eSpark-Backup/oliver-arc/Documents/Client-Shared/ARC103C_CURRENT VERSION/Assembly Pictures/T-U18W203868A-03.jpg

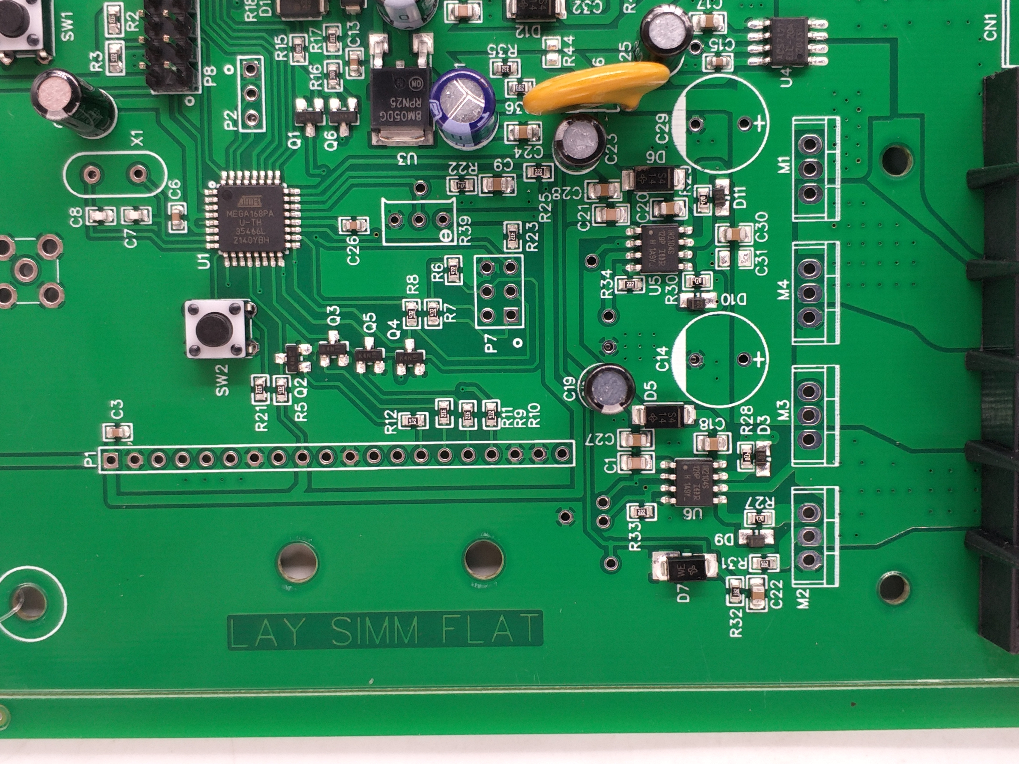
Documents/Client-Shared/ARC103C_CURRENT VERSION/Assembly Pictures/T-U18W203868A-03.jpg
