eSpark-Backup/oliver-arc/Documents/Client-Shared/ARC103C_CURRENT VERSION/BOMs/T-U18W203868A- ARC1.0.3C - 26122021.xlsx

Sheet: BOM Verfied by UK-DavidCousins
Columns C,D,E,F and G are the correct BOM (Parts idents are in Column F).
Column B is the original Quantity, column H is the original ident list do not use these there for reference only
Columns I,J and K are the original order codes for the devices use these for purchasing against the quantity in column D
Where columns I,J and K du not have the original order codes see the notes in column C, especially for the additional parts
 |  |  |  |  | Correct BOM checked December 2021
UK BUILD INFORMATION AND REVIEW - CORRECT BOM CHECK DECEMBER 2021 BY DAVID COUSINS / KAIZEN |  |  |  |  |  |  | CHINESE FACTORY BOM INFO
Column1 | Quantity | PB notes based on sample Board 06.10.2020 | Qty based on sample 06.10.2021 | Type | PB notes based on sample Board 06.10.20202 | PB notes based on sample Board 06.10.20203 | Original BOM data - ignore use Blue | Assembly Mounte Ref | Part description | part number supplied | NOTE | Column2
1 | 1 | ok | 1 | SMT | U1 |  | U1 | ATMEGA168 | ATMEGA168PA-AU | ATMEGA168PA-AU
2 | 2 | ok | 2 | SMT | U5,U6 |  | U5,U6 | IR2104 | IR2104STRPBF | IR2104STRPBF
3 | 1 | ok | 1 | SMT | U4 |  | U4 | ACS712 | ACS712ELCTR-20A-T SOIC-8_150MIL | ACS712ELCTR-20A-T
4 | 1 | ok marking = 8M05D | 1 | SMT | U3 |  | U3 | 78L05 | MC78M05ACDTG | MC78M05ACDTG | 5-7work days
5 | 1 | ok | 1 | SMT | U2 |  | U2 | MC34063 | MC34063 | MC34063AD
6 | 1 | ok | 1 | SMT | R42 |  | R42 | 0.3 0603 | 0.3 Ohm | CRL0603-FW-R300ELF
7 | 1 | ok | 1 | SMT | R40 |  | R40 | 180 0603 | 180 ohm | ERJ3RBD1800V | 5-7work days
8 | 1 | ok | 1 | SMT | R22 |  | R22 | 470K 0603 | 470K 0603
9 | 1 | ok | 1 | SMT | R43 |  | R43 | 1K 0603 | 1K
10 | 4 | ok | 4 | SMT | R27,R28,R29,R30 |  | R27,R28,R29,R30 | 47 | 47 Ohm Gate resistors |  |  |  | 603
11 | 1 | ok | 1 | SMT | R45 |  | R45 | 0 | Resistor 0 Ohm 0603 | CRCW06030000Z0EB |  |  | 603
12 | 6 | R4,R14 = 470, R13,R19,R20,R37 no silk on sample 06/10/20 or Schematic | 2 | SMT | R4,R14 | change | R4,R13, R14, R19, R20,R37 | 470 0603 | Resistor 470 0603
13 | 14 | R1,R2,R3,R38 = 4K7, R48 and R49 not fitted on sample 06/10/20 | 14 | SMT | R1,R2,R3,R5,R6,R7,R8,R9,R10,R11,R12,R21,R23,R38 |  | R1,R2,R3,R5,R6,R7,R8,R9,R10,R11,R12,R21,R23,R38 | 4K7 0603 | Resistor 4K7 0603
14 | 5 | ok | 3 | SMT | R25,R33,R34 | change | R15,R16,R25,R33,R34 | 2K2 0603 | Resistor 2K2 0603
15 | 3 | ok | 5 | SMT | R15,R16,R17,R18,R41 | change | R17,R18,R41 | 10K 0606 | Resistor 10k 0603
16 | 1 | ok | 1 | SMT | R24 |  | R24 | 33 1205 | Resistor 33 1206 | CRG1206F33R
17 | 1 | ok | 1 | SMT | R31 |  | R31 | 5K6 0603 | Resistor 5K6 0603 Motor spool
18 | 2 | ok | 2 | SMT | R32,R35 |  | R32,R35 | 3K3 0603 | Resistor 3K3 0603 |  |  |  |  |  | Motor spool + Batt Mon
19 | 1 | ok | 1 | SMT | R36 |  | R36 | 6K8 0603 | Resistor 6K8 0603 Batt Mon
20 | 1 | ok | 1 | CONV | R39 |  | R39 | POT 2K2 | Pot 2K2 3296w | 3296W-1-222LF | DNP
21 | 1 | ok | 1 | CONV | R46 |  | R26 | Varistor | VARISTOR 10A Clamp 43V Varistor 22V | 820541406 | 5-7work days
22 | 0 |  |  |  |  |  |  |  | Resistor 22 |  | DNP | NOT USED - redundant part
23 | 3 | D1 and D2 are SMAJ18CA-T on Sample board (marked ST part DBQ), D7 = SMAJ5.0CA (Not ST part on sample) | 1 | SMT | D7 | change | D1,D2,D7 | SMAJ5.0 | SMAJ5.0CA (DO-214AC) | SMAJ5.0CA
24 | 1 | ok D4 marked MMD | 1 | SMT | D4 |  | D4 | SS510 | SS510 5A Diode SMB(DO-214AA) | SS510 | Brand is MDD
25 | 7 | Marking K4N on these devices, Q8,Q9,Q10 not fitted on sample 06/10/20 | 7 | SMT | Q1,Q2,Q3,Q4,Q5,Q6,Q7 |  | Q2,Q3,Q4,Q5,Q1,Q6,Q7 | MMBT5551 | MMBT5551 SOT-23(SOT-23-3) | MMBT5551-7-F
26 | 4 | IRF3205 Fitted to sample 06/10/20 (will need fastenings) | 4 | CONV | M1,M3,M4,M2 |  | M1,M3,M4,M2 | IRF3205 | IRF3205PBF 110A 55V MOSFET TO-220 | IRF3205PBF | DNP
27 | 1 |  |  |  |  | change | D8 | Zenar 16V | Zenar 16V 6% 3 W SMT 2-Pin DO-214AC | BZG03C16TR | DNP
28 | 2 | Only LED3 fitted, | 1 | SMT | LED3 | change | LED3,LED4 | LED red | LED Red | LH R974-LP-1 | 5-7work days
29 | 1 | Not on silk or schematic |  |  | N/A | change | LED1 | LED green | LED Green | KP-2012CGCK | 5-7work days
30 | 1 | Not on silk or schematic |  |  | N/A | change | LED2 | LED yellow | LED Yellow | KPHCM-2012SYCK | 5-7work days
31 | 3 | ok all marked S4 = SS14 device | 3 | SMT | D5,D6,D12 |  | D5,D6,D12 | SS14 | SS14-E3/61T SMA(DO-214AC) | SS14-E3/61T
32 | 4 | ok all marked JP = 1N4148 device | 4 | SMT | D3,D9,D10,D11 |  | D3,D9,D10,D11 | 1N4148 | 1n4148 SMD | 1N4148WSF-7 | 5-7work days
33 | 1 | ok | 1 | SMT | L1 |  | L1 | 100uH | 100uH Inductor | SRN8040-101M | 5-7work days
34 | 1 | ok | 1 | CONV | C12 |  | C12 | 220uf | Capacitor 220uf | UVR1A221MED | 5-7work days |  |  |  | CAP-D6.3XF2.5 10v
35 | 3 | ok | 3 | CONV | C16,C14,C29 |  | C16,C14,C29 | 470uf | Capacitor 470u 10mm OD 50V | ECA1HM471 | 5-7work days
36 | 1 | ok | 1 | CONV | C11 |  | C11 | 100uf | Capacitor 100uf | ECA1VM101 | 5-7work days |  |  |  | CAP-D6.3XF2.5 35v
37 | 2 | ok | 2 | SMT | C34,C35 |  | C34,C35 | 10Uf Tant | 10uf 35v Tant capacitor | TAJC106K035RNJ | 3-4work days
38 | 4 | ok | 4 | CONV | C2,C19,C23,C25 |  | C2,C19,C23,C25 | 10Uf | 10u | ECA1HM100 | 5-7work days |  | 5x2 50v PC
39 | 11 | 1u listed in Schematics | 11 | SMT | C4,C5,C9,C17,C18,C20,C22,C24,C27,C28,C30 |  | C4,C5,C9,C17,C18,C20,C22,C24,C27,C28,C30 | 1uf 0805 | Capacitor 1u 0805 | CL21B105KBFNNNF
40 | 3 | 100n listed in Schematics | 3 | SMT | C1,C21,C10 |  | C1,C21,C10 | 100n 50v 0805 | 100n 0805 50v | C0805C104M5RACTU |  |  |  |  | C1,21,C10
41 | 2 | 18p listed in Schematics | 2 | SMT | C7,C8 |  | C7,C8 | 18P 0603 | Capacitor 18P 0603 | 06031A180JAT2A | 5-7work days
42 | 8 | 100n listed in Schematics | 8 | SMT | C3,C6,C13,C15,C26,C37,C36,C33 |  | C3,C6,C13,C15,C26,C37,C36,C33 | 100n 0603 | 100n 0603 | GRM188F51E104ZA01D |  |  |  | 25v
43 | 1 | 1n listed in Schematics | 1 | SMT | C32 |  | C32 | 1n 0603 | 1nf | 06031C102KAT2A
44 | 0 |  |  |  |  |  |  |  | 470P? |  | DNP | NOT USED - redundant part
45 | 1 | Not purchased (RS 704-3278) added to purchase list | 1 | CONV | P1 |  |  | RDF1 | RDF1 | RDF1 | DNP | PLEASE SOURCE FROM https://www.rfsolutions.co.uk/
46 | 1 | Purchased | 1 | CONV | J1 |  |  | Antenna | Antenna with Pig Tail - 433MHz 2db gain | ANT-433WPIG-2SMA | DNP
47 | 1 |  |  |  |  | change |  | Key fob | Key fob |  | DNP | PLEASE SOURCE FROM https://www.rfsolutions.co.uk/
48 | 1 | Purchased | 1 | CONV | SG1 |  |  | Buzzer | BUZZER 12mm 5V | KXG1203C | Out of stock, please kindly advise alternatives.
49 | 1 | Purchased SMT Device (Bend pins and fit through the PCB) | 1 | CONV | X1 |  | X1 | 12MHz288 | 12.288 MHZ HC49 | ABLS-12.288MHZ-B2-T | 5-7work days
50 |  | Not purchased (Fitted on sample 06/10/20) (RS 251-8288) | 1 | CONV | P8 | change |  |  | LCD Header 16 pin |  | DNP | LCD version only
51 |  |  |  |  |  |  |  |  | lCD IDC PLUG 16 pin |  | DNP | LCD version only
52 |  |  |  |  |  |  |  |  | Box |  | DNP | GrippaTank – see Olly – requires drilling
53 | 2 | ok | 2 | CONV | SW1,SW2 |  | SW1,SW2 | Switch | SWITCH-6x6x5_TH | 1825910-6 | 7-10work days
54 |  |  |  |  |  |  |  |  | PCB |  | PCB | GrippaTank specically made – see Olly
55 | 1 | Purchased (Fitted on sample 06/10/20) (RS 822-7070) | 1 | CONV | No Ident on silk Screen (next to CN1) |  |  |  | Barrer strip 4 contact Molex 9.53mm Pitch 15A | 38720-6204 | 5-7work days
56 | 1 | Purchased (Fitted on sample 06/10/20) (RS 897-0749) | 1 | CONV | CN1 |  | CN1 |  | Terminal screw block for hand remote | 897-0749 | DNP
57 | 6 | Purchased SMT part (Fitted on sample 06/10/20) (Buy RS 251-8137) | 1 | CONV | P7 | change | P7 | 3x2 | Header pins 0.1 inch |  | DNP | Standard 0.1” header pins
58 | 4 | Purchased - Fitted to Sample 06/10/20 | 4 | Mech | (M1,M3,M4,M2) assembly Insulator/Busj |  |  |  | Heatsink MOSFET insulator and bush |  | DNP | Farnell – packet of 10!!
59 | 4 | Purchased - Fitted to Sample 06/10/20 | 4 | Mech | (M1,M3,M4,M2) assembly washer |  |  |  | Heatsink MOSFET Steel washer M3 |  | DNP | Washer for nut side of MOSFET bolt
 | 4 | Purchased - Fitted to Sample 06/10/20 | 4 | Mech | (M1,M3,M4,M2) assembly Screw |  |  |  | Heatsink MOSFET machine screw M3 X 12 |  | DNP | Bolt for MOSFET to heatsink
 | 2 | Purchased - Fitted to Sample 06/10/20 | 2 | Mech | (M1,M3,M4,M2) assembly Screw |  |  |  | Heatsink machine screw M3 X 9 |  | DNP | Heatsink to PCB bolt
60 | 2 | Purchased - Fitted to Sample 06/10/20 | 2 | Mech | (M1,M3,M4,M2) assembly washer |  |  |  | Heatsink M3 steel washer |  | DNP | Heatsink to PCB underside washer
61 | 1 | Purchased - Fitted to Sample 06/10/20 | 2 | Mech | (M1,M3,M4,M2) assembly washer | change | Nylon washer / steel washer /nut |  | Heatsink M3 Nylon washer |  | DNP | Heatsink to PCB underside nylon washer ( By MOSFET M1 )
62 |  |  |  |  |  |  |  |  |  |  | DNP
63 | 2 |  |  |  |  | change |  |  | Machine screw M3 x 16 |  | DNP | Terminaltion block securing screw
64 | 2 |  |  |  |  | change |  |  | M3 Steel washer |  | DNP | Terminaltion block securing screw underside Steel washer
65 | 1 |  |  |  |  | change | Nylon washer / steel washer /nut |  | M3 Nylon washer |  | DNP | Terminaltionterminal ) block securing screw underside Nylon washer ( by 12V+
 | 8 | Purchased - Fitted to Sample 06/10/20 | 4 | Mech | (M1,M3,M4,M2) assembly Nut | change |  |  | M3 Nyloc nut |  | DNP | Nyloc nuts for all M3 machine screws
66 | 1 |  |  |  |  | change |  |  | Cable clamp 16MM thread – Black | NGM16-BLK | DNP
67 | 1 |  |  |  |  | change |  |  | Cable clamp 12MM thread – Black | NGM12-BLK | DNP | Needs slightly longer threaded version!!
68 | 4 |  |  |  |  | change |  |  | PCB mounting screws 6-32 x ¼ UNC cap screw |  | DNP | GrippTank sourced – see Olly
69 | 1 |  |  |  |  | change |  |  | Right angle 70mm heat-sink |  | DNP | GrippaTank specically made – see Olly
70 | 1 | Not Purchased (Added FEC 8783551 to prurchase list) |  |  |  | change |  |  | Heatsink bottom insulator |  | DNP | Custom made to suit heat-sink area
 | PB added | Molex connector fitted on sample 06/10/20 (RS 170-7177) | 1 | CONV | JP2 | change |  | Fitted on sample
 | PB added | SMAJ18CA (DO-214AC (Farnell 1749352) | 2 | SMT | D1,D2 | change |  | Fitted on sample
 | PB added | 0.1" pitch 1 x 3 header (RS 251-8092) | 1 | CONV | P2 | change |  | Fitted on sample
 | PB added | Confirmed with sample 06/10/20 and Schematic | 7 | NF | Q8,Q9,Q10,R44,R48,R49,C31 | change |  | NOT FITTED

Sheet: BOM Sent to China Factory
Last Revision: 26/12/2021 - Validated and Compared with Build Unit as emailed by D.C/KT - 13/12/21
100sets |  | CUSTOMER REPLY | part number supplied |  | Part description | MOQ | Quantity | Package | Supplier | Supplier Code | Alternative | Assembly Mounted | Ref
$6.710 |  | - | ATMEGA168PA-AU | 43 | ATMEGA168PA-AU |  | 1 | TQFP32 | RS | 696-3244 |  | ATMEGA168 | U1
$1.760 |  | - | IR2104STRPBF | 70 | IR2104STRPBF |  | 2 |  | RS | 831-2724 |  | IR2104 | U5,U6
$3.080 |  | - | ACS712ELCTR-20A-T | 51 | ACS712ELCTR-20A-T SOIC-8_150MIL |  | 1 |  | RS | 680-7135 |  | ACS712 | U4
$0.660 | 7-10work days | No Problem | MC78M05ACDTG | 46 | MC78M05ACDTG |  | 1 |  | RS | 688-9288 |  | 78L05 | U3
$0.550 |  | - | MC34063AD | 1 | MC34063 |  | 1 |  | RS | 661-8436 |  | MC34063 | U2
$0.242 | 7-10work days | No Problem | CRL0603-FW-R300ELF | 1 | 0.3 Ohm |  | 1 |  | RS | 794-4112 |  | 0.3 0603 | R42
$0.088 | 7-10work days | No Problem | ERJ3RBD1800V | 80 | 180 ohm |  | 1 |  | RS | 810-2157 |  | 180 0603 | R40
$0.008 |  | - |  | 4000 | 470K 0603 | Reel of 5000 = 3.77 | 1 |  | RS | 804-9069 |  | 470K 0603 | R22
$0.008 |  | - |  | 4000 | 1K | Reel 0f 5000 = 3.61 | 1 |  | RS | 804-8845 |  | 1K 0603 | R43
$0.008 |  | - |  | 4000 | 47 Ohm Gate resistors | Reel 0f 5000 = 3.57 | 4 |  | RS | 804-8748 |  | 47 0603 | R27,R28,R29,R30
$0.008 |  | - | CRCW06030000Z0EB | 80 | Resistor 0 Ohm 0603 | Packet of 50 = 0.40 | 1 |  | RS | 678-9670 |  | 0 0603 | R45
$0.008 |  | - |  | 4000 | Resistor 470 0603 | Reel 0f 5000 = 3.77 | 6 | R0603 | RS | 804-8827 |  | 470 0603 | R4,R13, R14, R19, R20,R37
$0.008 |  | - |  | 4000 | Resistor 4K7 0603 | Reel of 5000 = 3.77 | 14 | R0603 | RS | 804-8909 |  | 4K7 0603 | R1,R2,R3,R5,R6,R7,R8,R9,R10,R11,R12,R21,R23,R38,R47,R48,R49
$0.008 |  | - |  | 4000 | Resistor 2K2 0603 | Reel of 5000 = 3.77 | 5 |  | RS | 804-8861 |  | 2K2 0603 | R25,R33,R34
$0.008 |  | - |  | 4000 | Resistor 10k 0603 | Reel of 5000 = 3.56 | 3 |  | RS | 804-8921 |  | 10K 0606 | R15,R16,R17,R18,R41
$0.017 |  | - | CRG1206F33R | 30 | Resistor 33 1206 | Packet of 50 = 1.35 | 1 |  | RS | 223-2063 |  | 33 1205 | R24
$0.008 |  | - |  | 4000 | Resistor 5K6 0603 Motor spool | Reel 0f 5000 = 3.77 | 1 |  | RS | 804-8899 |  | 5K6 0603 | R31
$0.008 |  | - |  | 4000 | Resistor 3K3 0603 Motor spool + Batt Mon | Reel 0f 5000 = 3.77 | 2 |  | RS | 804-8877 |  | 3K3 0603 | R32,R35
$0.008 |  | - |  | 4000 | Resistor 6K8 0603 Batt Mon | Reel 0f 5000 = 3.77 | 1 |  | RS | 804-8915 |  | 6K8 0603 | R36
 | NO NEED? | Yes we do need, but if can't supply, we will add them ourselves here | 3296W-1-222LF | 34 | Pot 2K2 3296w | Tube of 50 = 31.45 | 1 |  | RS | 161-6985 |  | POT 2K2 | R39
$1.100 | 7-10work days | No Problem | 820541406 | 50 | VARISTOR 10A Clamp 43V Varistor 22V |  | 1 |  | RS | 669-4358 |  | Varistor | R46
 | NO NEED? | NO NEED |  | 4000 | Resistor 22
$0.220 |  | - | SMAJ18CA-TR |  | SMAJ18CA-T (DO214AC) |  | 2 |  | RS | 714-1026 |  | SMAJ18CA-T | D1,D2
$0.220 |  | - | SMAJ5.0CA |  | SMAJ5.0CA (DO-214AC) |  | 1 |  | RS | 764-5568 |  | SMAJ5.0 | D7
$0.220 | brand is MDD | - | SS510 | 34 | SS510 5A Diode SMB(DO-214AA) | Packet of 50 = 5.70 | 1 |  | RS | 917-9174 |  | SS510 | D4
$0.132 |  | - | MMBT5551-7-F | 0 | MMBT5551 SOT-23(SOT-23-3) | Packet of 100 = 4.00 | 7 | SOT-23 | RS | 751-4515 |  | MMBT5551 | Q2,Q3,Q4,Q5,Q1,Q6,Q7
 | NO NEED? | Yes we do need, but if can't supply, we will add them ourselves here | IRF3205PBF | 270 | IRF3205PBF 110A 55V MOSFET TO-220 | Tube of 50 = 34.50 | 4 |  | RS | 919-4763 |  | IRF3205 | M1,M3,M4,M2
 | NO NEED? | Yes we do need, but if can't supply, we will add them ourselves here | BZG03C16TR | 12 | Zenar 16V 6% 3 W SMT 2-Pin DO-214AC |  | 1 |  | RS | 814-2783 |  | Zenar 16V | D8
$0.055 | Out of stock, we will supply LTST-C170KRKT 0805 red | NO PROBLEM | LH R974-LP-1 | 25 | LED Red | Packet of 50 = 3.65 | 2 | L0805 | RS | 654-5818 |  | LED red | LED3,LED4
$0.649 | 7-10work days | No Problem | KP-2012CGCK | 30 | LED Green | Packet of 50 = 2.70 | 1 | L0805 | RS | 861-0037 |  | LED green | LED1
$0.649 | MOQ:5pcs7-10work days | No Problem | KPHCM-2012SYCK | 25 | LED Yellow | Packet of 50 = 5.25 | 1 | L0805 | RS | 861-0113 |  | LED yellow | LED2
$0.110 |  | - | SS14-E3/61T | 45 | SS14-E3/61T SMA(DO-214AC) | Packet of 100 = 6.80 | 3 |  | RS | 652-7551 |  | SS14 | D5,D6,D12
$0.110 |  | - | 1N4148WSF-7 | 80 | 1n4148 SMD | Pack of 100 | 4 |  | RS | 133-5600 |  | 1N4148 | D3,D9,D10,D11
 | Please advise part number. | SRN8040-101M |  | 6 | 100uH Inductor |  | 1 |  | RS |  |  | SRN8040-101M | L1
 | Please advise part number. | UVR1A221MED |  | 250 | Capacitor 220uf CAP-D6.3XF2.5 10v |  | 1 |  | RS |  |  | 220uf | C12
 | Out of stock, please kindly advise alternatives. |  | ECA1HM471 | 8 | Capacitor 470u 10mm OD 50V |  | 3 |  | RS | 228-6925 |  | 470uf | C16,C14,C29
$0.220 |  | - | ECA1VM101 | 7 | Capacitor 100uf CAP-D6.3XF2.5 35v | Packet of 200 = 8.80 | 1 |  | RS | 228-6767 |  | 100uf | C11
$0.550 |  | - | TAJC106K035RNJ | 7 | 10uf 35v Tant capacitor |  | 2 |  | RS | 464-7861 |  | 10Uf Tant | C34,C35
$0.132 | 7-10work days | No Problem | ECA1HM100 | 100 | 10u 5x2 50v PC | Packet of 200 = 6.40 | 4 |  | RS | 107-8079 |  | 10Uf | C2,C19,C23,C25
$0.017 |  | - | CL21B105KBFNNNF | 700 | Capacitor 1u 0805 | Packet of 100 = 3.60 | 11 |  | RS | 766-1062 |  | 1uf 0805 | C4,C5,C9,C17,C18,C20,C22,C24,C27,C28,C30
$0.017 |  | - | C0805C104M5RACTU | 400 | 100n 0805 50v C1,21,C10 | Reel of 500 = 7.00 | 3 |  | RS | 802-9920 |  | 100n 50v 0805 | C1,21,C10
$0.099 | 7-10work days | No Problem | 06031A180JAT2A | 200 | Capacitor 18P 0603 | Reel of 250 = 250 | 2 |  | RS | 135-6553 |  | 18P 0603 | C7,C8
$0.017 |  | - | GRM188F51E104ZA01D | 100 | 100n 0603 25v | Packet of 200 = 1.80 | 8 | C0603 | RS | 723-5521 |  | 100n 0603 25v | C3,C6,C13,C15,C26,C37,C36,C33
$0.009 |  | - | 06031C102KAT2A | 450 | 1nf |  | 1 |  |  | 135-6559 |  | 1n 0603 | C32
 | Please advise part number. | NOT USED - REDUNDANT PART |  |  | 470P?
 | NO NEED? | https://www.rfsolutions.co.uk/radio-modules-c10/rdf1-fm-receiver-decoder-module-sil-5-volt-433mhz-p288 | RDF1 | 5 | RDF1 |  | 1 | SIM | RS for now | 704-3278 |  | RDF1
 | NO NEED? | https://www.rfsolutions.co.uk/antennas-c8/2dbi-compact-433mhz-whip-antenna-p122 | ANT-433WPIG-2SMA | 50 | Antenna with Pig Tail - 433MHz 2db gain |  | 1 |  | RS | 793-4351 |  | Antenna
 | Please advise part number. | https://www.rfsolutions.co.uk/remote-control-systems-c9/hornet200-3-button-150m-433mhz-keyfob-transmitter-p764 |  |  | Key fob |  |  |  |  |  |  | Key fob
$2.310 | MOQ:5pcs 7-10work days | No Problem | KXG1203C | 50 | BUZZER 12mm 5V |  | 1 |  | RS | 771-6957 | 767-5367 | Buzzer | SG1
$0.396 | 7-10work days | No Problem | ABLS-12.288MHZ-B2-T | 60 | 12.288 MHZ HC49 | Tube of 25 = 4.25 | 1 |  | RS | 171-0516 |  | 12MHz288 | X1
 | Please advise part number. | 251-8288 |  |  | LCD Header 16 pin |  |  |  | RS | 251-8288 |  |  | P8
 | Please advise part number. | NO NEED |  |  | lCD IDC PLUG 16 pin
 | Please advise part number. | NO NEED |  |  | Box
$0.148 | 6-8work days only have 260pcs in stock | No Problem | 1825910-6 | 80 | SWITCH-6x6x5_TH | Packet of 20 = 1.40 | 2 | 6x6 | RS | 479-1413 |  | Switch | SW1,SW2
 | PCB | - |  |  | PCB
$3.223 | 7-10work days | No Problem | 38720-6204 | 0 | Barrer strip 4 contact Molex 9.53mm Pitch 15A |  | 1 |  | RS | 822-7070
 | NO NEED? | NO NEED |  | 0 | Terminal screw block for hand remote |  | 1 |  | RS | 897-0749
 | NO NEED? | NO NEED |  | 0 | Header pins 0.1 inch |  |  |  | RS | 251-8092 |  |  | P2
 | NO NEED? | NO NEED |  |  | Heatsink insulator |  | 4
 | NO NEED? | NO NEED |  |  | Heatsink washer |  | 4
 | NO NEED? | NO NEED |  |  | Heatsink M3 X 12 |  | 4
 | NO NEED? | NO NEED |  |  | Heatsink M3 Nylock |  | 8
 | NO NEED? | NO NEED |  |  | Heatsink M3 X 12 chassis bolt |  | 2
 | NO NEED? | NO NEED |  |  | M3 washer |  | 8
 | NO NEED? | NO NEED |  |  | M3 Nylon washer |  | 1
 | NO NEED? | NO NEED |  |  | M3 x 16mm Terminal block bolts |  | 2
 | NO NEED? | NO NEED |  | 6 | Cable clamp 16MM thread – Black |  | 1
 | NO NEED? | NO NEED |  | 6 | Cable clamp 12MM thread – Black |  | 1
 | NO NEED? | NO NEED |  |  | 6BA PCB mounting screws |  | 4
 | NO NEED? | NO NEED |  |  | Right angle 70mm heat-sink |  | 1
 | NO NEED? | NO NEED |  |  | Heatsink bottom insulator |  | 1
