eSpark-Backup/oliver-arc/Documents/Client-Shared/ARC103C_CURRENT VERSION/Assembly Pictures/G214MF-AEK-R2 ( by Gainta )(2).PDF

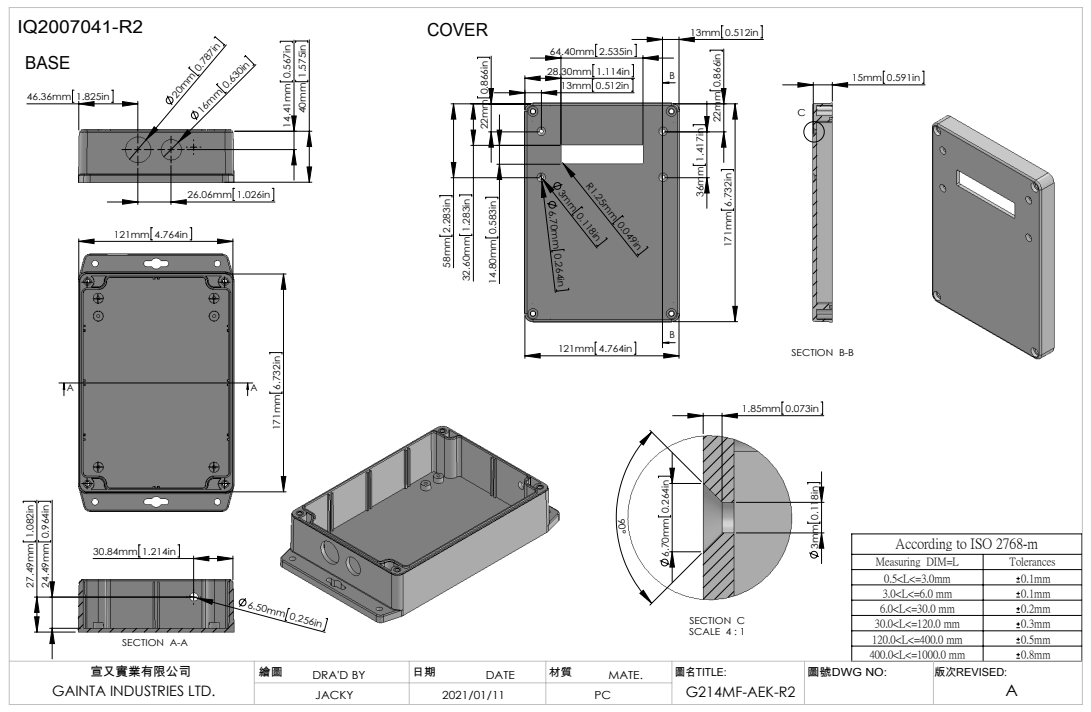
[picture p6: page 1]
SECTION A-A; SECTION B-B; SECTION C SCALE 4 : 1

According to ISO 2768-m

Measuring DIM=L | Tolerances
0.5<L<=3.0mm | 0.1mm
3.0<L<=6.0 mm | 0.1mm
6.0<L<=30.0 mm | 0.2mm
30.0<L<=120.0 mm | 0.3mm
120.0<L<=400.0 mm | 0.5mm
400.0<L<=1000.0 mm | 0.8mm

宣又實業有限公司 GAINTA INDUSTRIES LTD. | 繪圖 DRA'D BY | 日期 DATE | 材質 MATE. | 圖名TITLE: G214MF-AEK-R2 | 圖號DWG NO: | 版次REVISED: A

JACKY | 2021/01/11 | PC
