eSpark-Backup/oliver-arc/Documents/Client-Shared/ARC103C_CURRENT VERSION/VS-1-S.v13.pdf

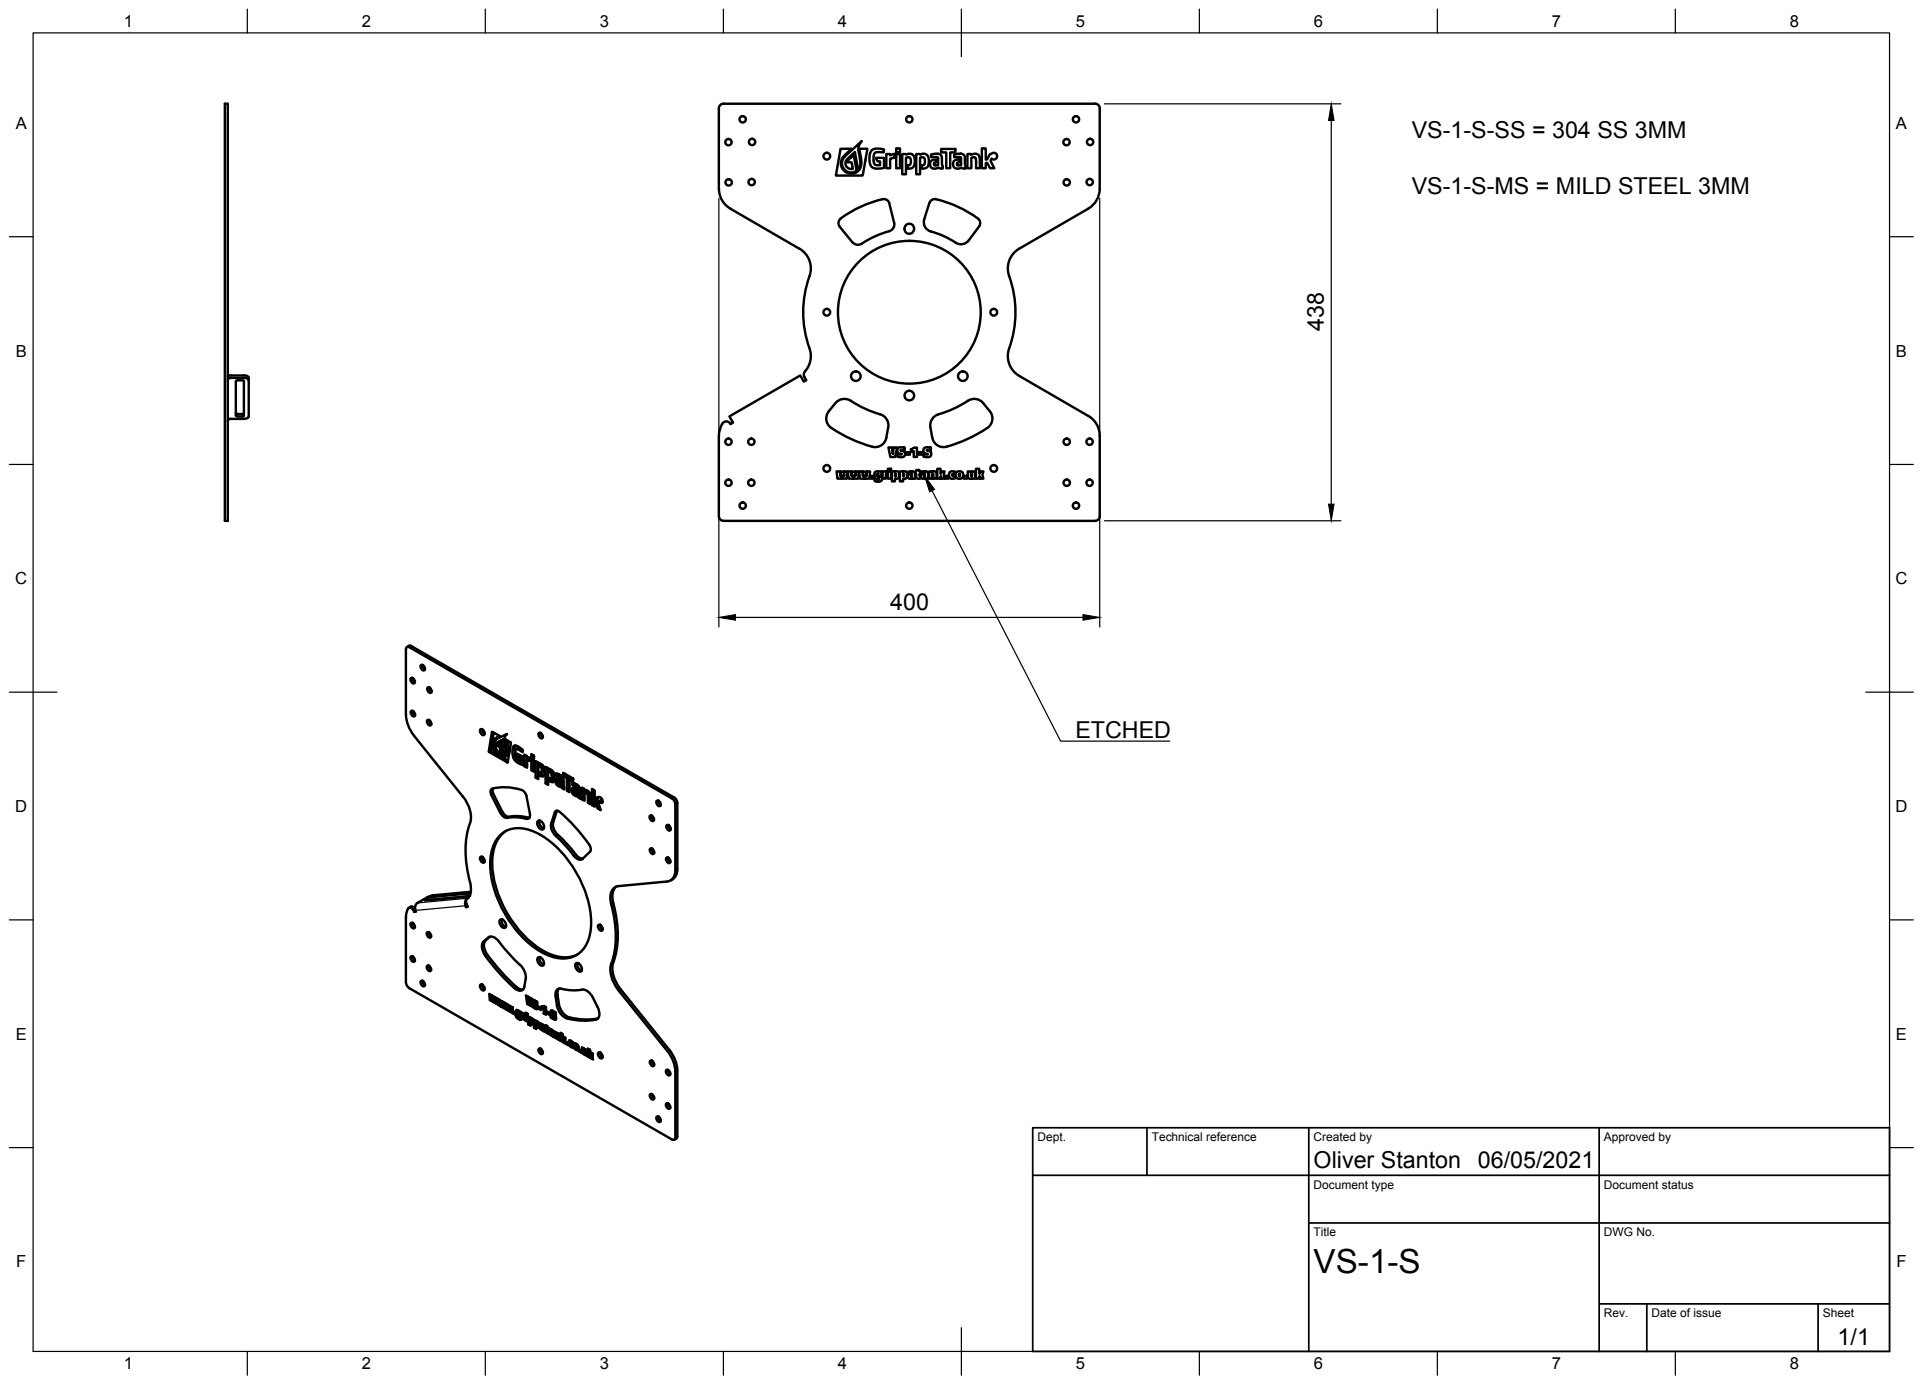
[picture p7: page 1]
Title; DWG No.; Rev.; Date of issue; Sheet

Oliver Stanton 438

VS-1-S-MS = MILD STEEL 3MM

Dept. | Technical reference | Created by 06/05/2021 | Approved by

Document type | Document status
