eSpark-Backup/oliver-arc/Documents/Client-Shared/ARC103C_LCD/Schematics/ARC103C_LCD_LAYOUT_SCH.pdf

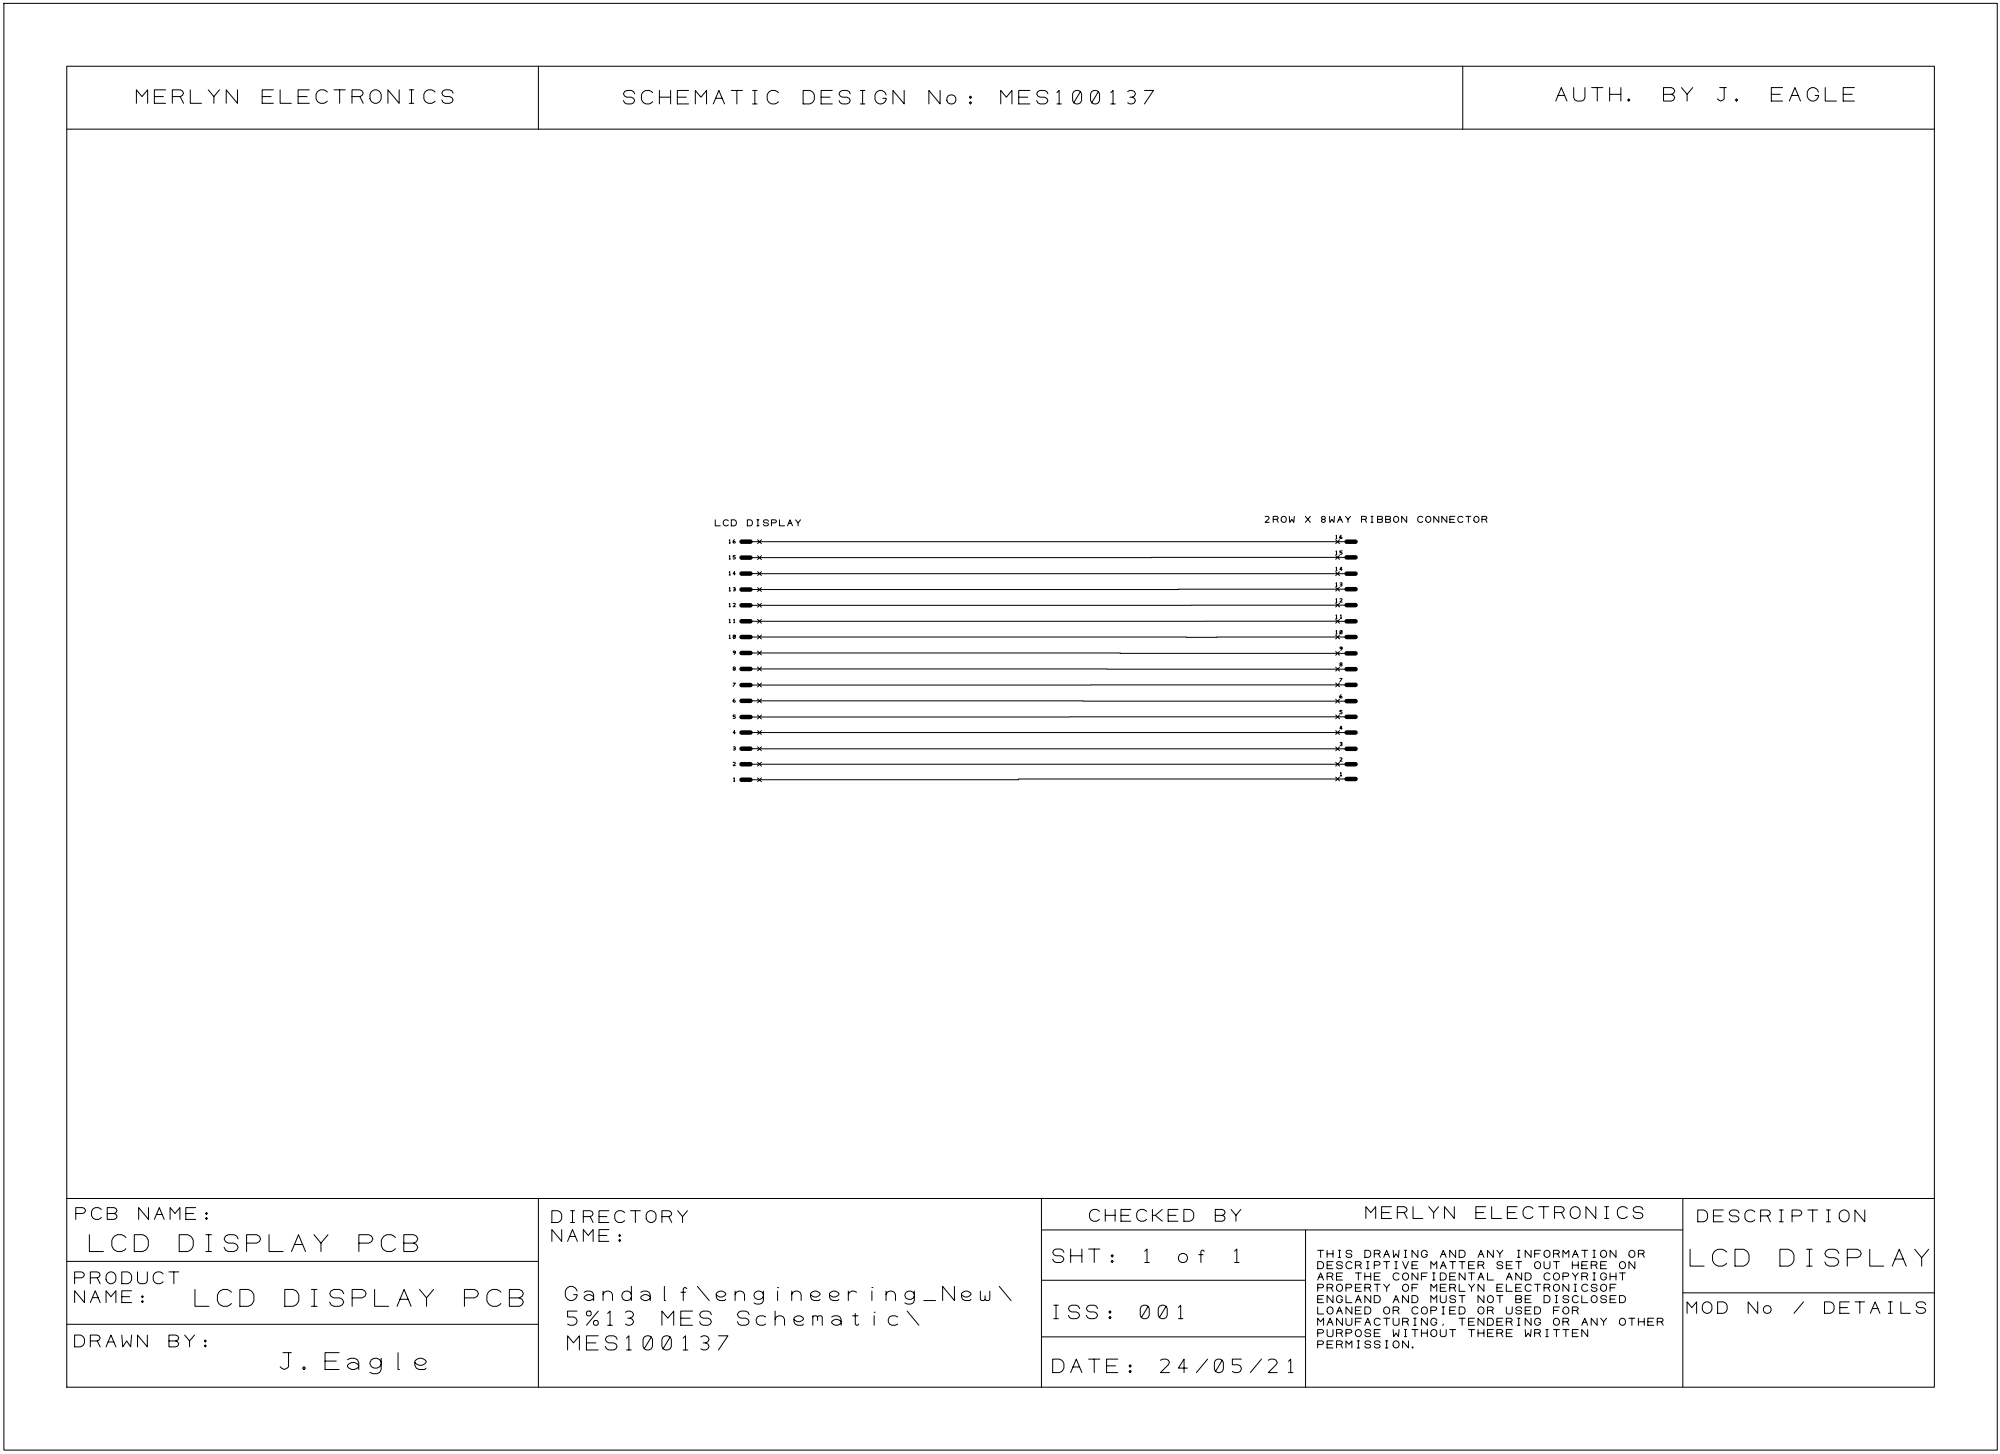
[picture p8: page 1]
HD1XZa; HD1XZaXZ1; HD1XZb; HD1XZbXZ2; HD1XZc; HD1XZcXZ3; HD1XZd; HD1XZdXZ4; HD1XZe; HD1XZeXZ5; HD1XZf; HD1XZfXZ6; HD1XZg; HD1XZgXZ7; HD1XZh; HD1XZhXZ8; HD1XZi; HD1XZiXZ9; HD1XZj; HD1XZjXZ10; HD1XZk; HD1XZkXZ11; HD1XZl; HD1XZlXZ12; HD1XZm; HD1XZmXZ13; HD1XZn; HD1XZnXZ14; HD1XZo; HD1XZoXZ15; HD1XZp; HD1XZpXZ16; LCD1XZa; LCD1XZaXZ1; LCD1XZb; LCD1XZbXZ2; LCD1XZc; LCD1XZcXZ3; LCD1XZd; LCD1XZdXZ4; LCD1XZe; LCD1XZeXZ5; LCD1XZf; LCD1XZfXZ6; LCD1XZg; LCD1XZgXZ7; LCD1XZh; LCD1XZhXZ8; LCD1XZi; LCD1XZiXZ9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
