eSpark-Backup/oliver-arc/Documents/Client-Shared/ARC103C_CURRENT VERSION/Archive/Schematic_Reel Controller 1.0.3C- 0.25 rebox_Reel - ATMEGA168 - Relay 1.0.3C_20200105185349.pdf

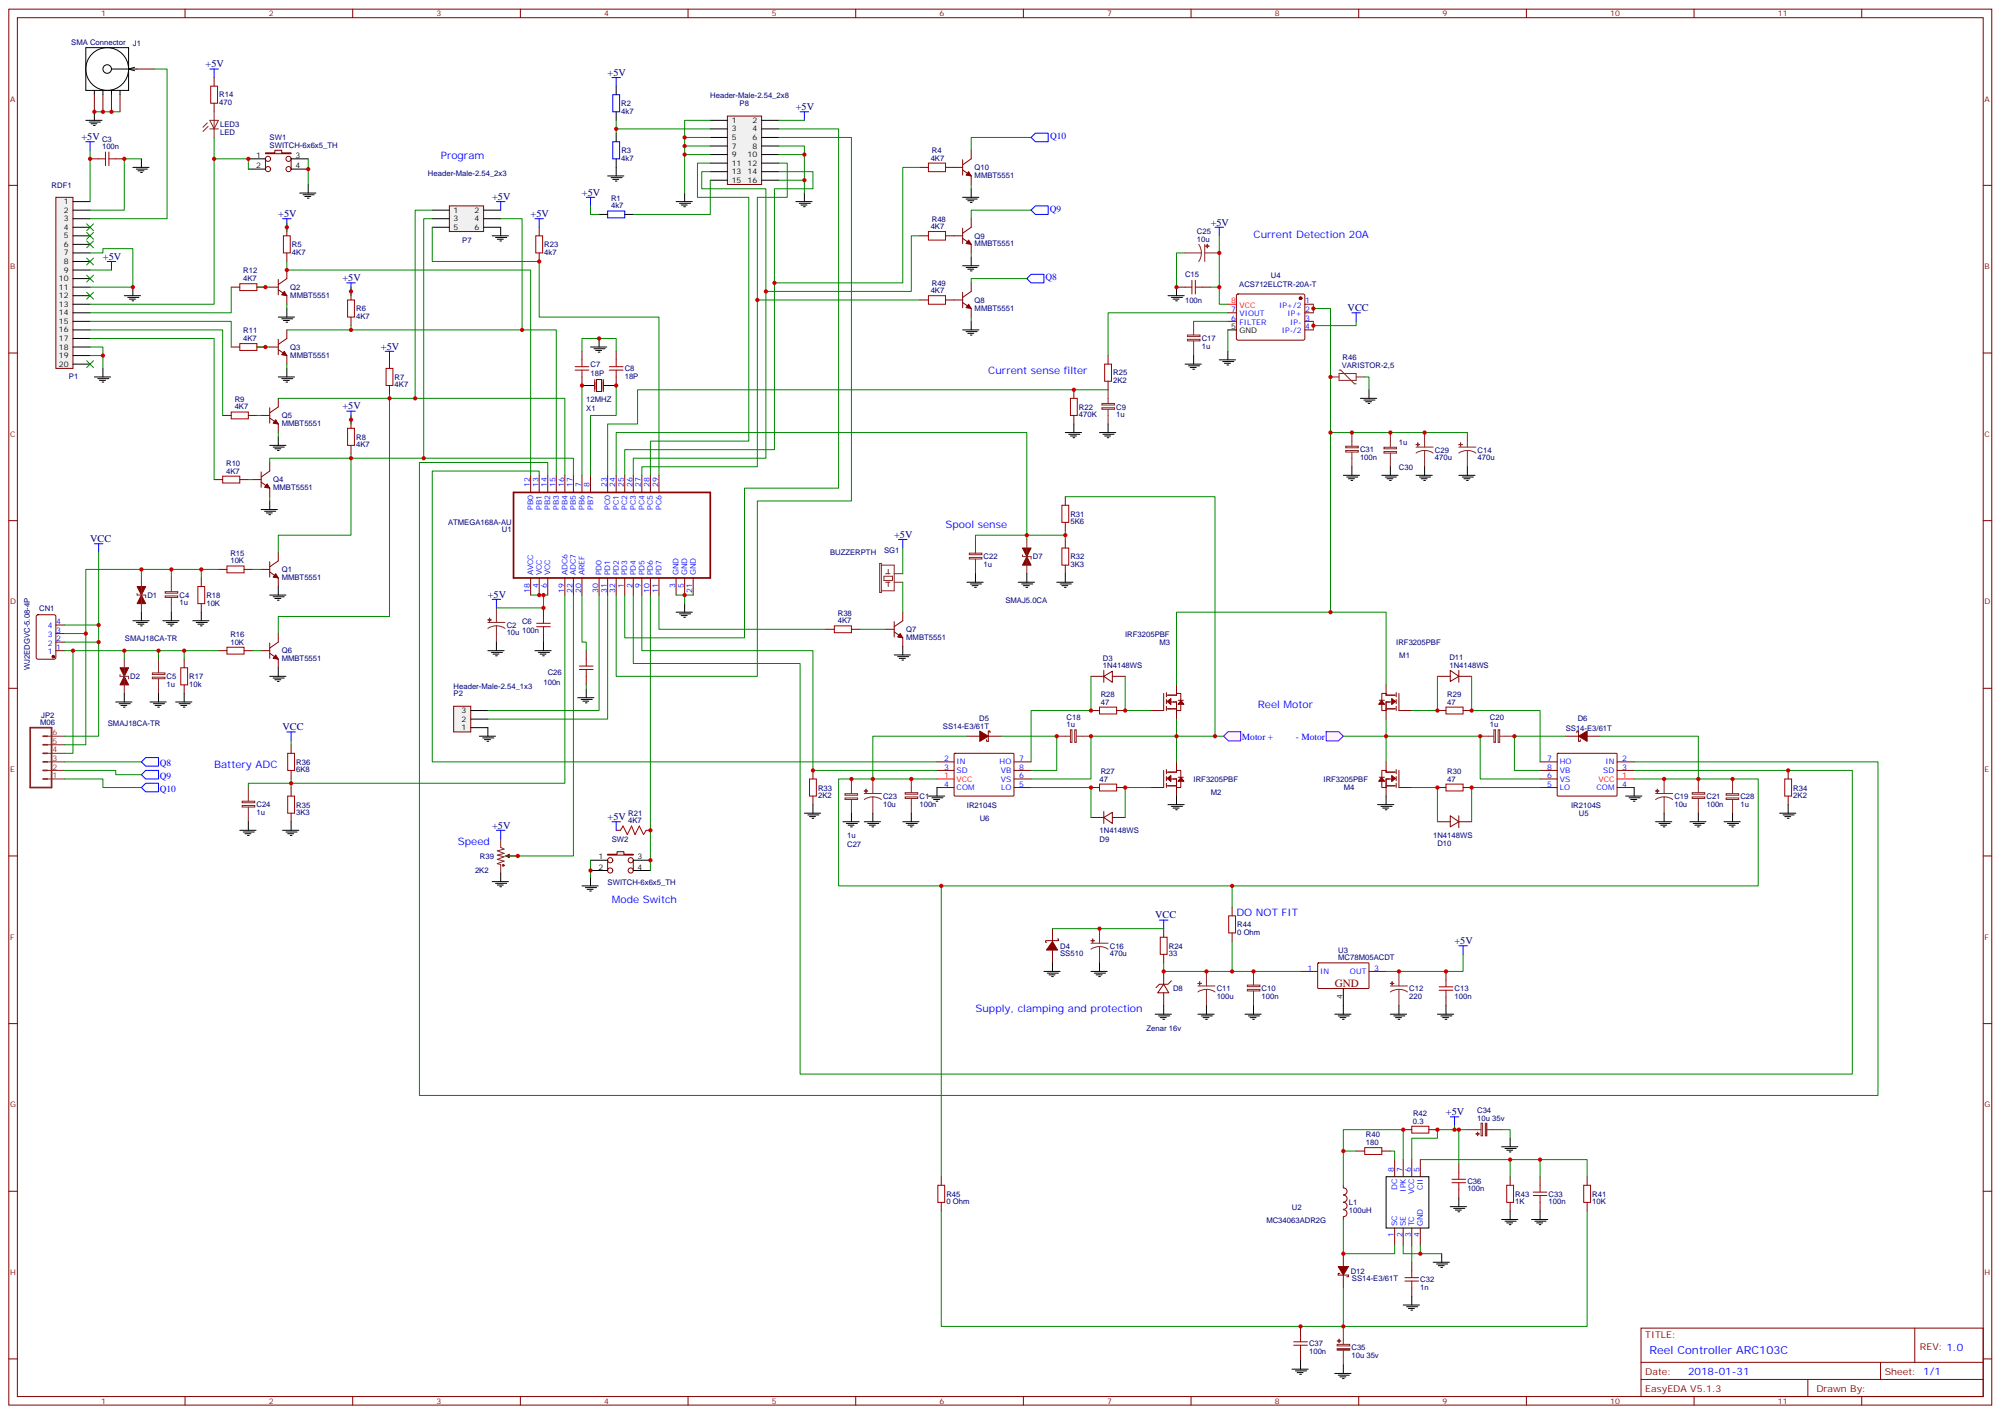
[picture p9: page 1]

Supply, clamping and protection
