eSpark-Backup/oliver-arc/(list of files, drawings)

Other design files:
Design-Files/ARC_1.0.5/ARC_1.0.5.PrjPcb
Design-Files/ARC_1.0.5/Connector_Section.SchDoc
Design-Files/ARC_1.0.5/Controller_Section.SchDoc
Design-Files/ARC_1.0.5/Current_Sense_Section.SchDoc
Design-Files/ARC_1.0.5/Motor_Driver_Section.SchDoc
Design-Files/ARC_1.0.5/Power_Section.SchDoc
Design-Files/ARC_1.0.5/Top_Sheet.SchDoc
Design-Files/LCD_Board_1.0.3/LCD_Board.PcbDoc
Design-Files/LCD_Board_1.0.3/LCD_Board_1.0.3.PrjPcb
Design-Files/LCD_Board_1.0.3/LCD_Connectors.SchDoc
Library-Files/PcbLib.PcbLib
Library-Files/Schlib.SchLib
