eSpark-Backup/oliver-arc/Documents/Client-Shared/ARC103C_CURRENT VERSION/Software/src/interrupts.h

/**************************************************************************************************
 * \file			interrupts.h
 * \description		
 *
 * \date			
 * \version			1.0.1
 * \brief           
 *
 *************************************************************************************************/

#ifndef INTERRUPTS_H_
#define INTERRUPTS_H_

#define START 1
#define STOP 0

void BackMonitor( uint8_t state );

#endif /* INTERRUPTS_H_ */
