eSpark-Backup/oliver-arc/Documents/Client-Shared/ARC103C_CURRENT VERSION/Software/src/lcd.h

/**************************************************************************************************
 * \file			lcd.h
 * \description		
 *
 * \date			
 * \version			1.0.1
 * \brief           
 *
 *************************************************************************************************/

#ifndef LCD_H_
#define LCD_H_

// used pins on port C and D
#define LCD_E  2    // PORTD.2
#define LCD_RS 3    //PORTD.3   ------------
//#define LCD_RD 7    // PORTD.7
//#define LCD_WR 6    // PORTD.6
// Data and Busy flag are on PORTA

#define LCD_DB4  5  // PORTC.5
#define LCD_DB5  4  // PORTC.4
#define LCD_DB6  3  // PORTC.3
#define LCD_DB7  2  // PORTC.2
//LCD commands
#define LCD_CLR 0x01  // clear LCD
#define LCD_4BIT 0x32 // 8-bit mode
#define LCD_INC 0x06  //Increment, display freeze
#define LCD_MOV 0x10  //Cursor move, not shift
#define LCD_ALL  0x0F // LCD On, LCD display on, cursor on and blink on
#define LCD_ON           0x08      // turn lcd/cursor on
#define LCD_ON_DISPLAY   0x04      // turn display on
#define LCD_ON_CURSOR    0x02      // turn cursor on
#define LCD_ON_BLINK     0x01      // cursor blink
#define LCD_LINE1  0x80        // cursor Pos on line 1 (or with column)
#define LCD_LINE2  0xC0        // cursor Pos on line 2 (or with column)


void nopDelay( void );

void LCD_wait(void);
void LCD_putchar(unsigned char data);
void LCD_half_command(unsigned char command);
void LCD_command(unsigned char command);
void LCD_init(void);
void LCD_write(char* dstring);

#endif /* LCD_H_ */
