eSpark-Backup/oliver-arc/Documents/Client-Shared/ARC103C_CURRENT VERSION/Software/src/utils.c

/**************************************************************************************************
 * \file			utils.c
 * \description		
 *
 * \date			
 * \version			1.0.1
 * \brief           
 *
 *************************************************************************************************/

#include <string.h>
#include <avr/io.h>
#include <stdio.h>
#include <avr/interrupt.h>
#include "defs.h"
#include "utils.h"

/**************************************************************************************************
 * \fn 			
 * \brief
 *
 *************************************************************************************************/
void sleepms( int ms )
{
	int n;

	while( ms-- )
	{
		for( n=0;n<650;n++ );
	}
}

/**************************************************************************************************
 * \fn 			
 * \brief
 *
 *************************************************************************************************/
void sleep( int tm )
{
	long n;
	int i;

	for(i=0;i< tm; i++ )
	{
		n = 10000;
		while( n-- );
	}
}

/**************************************************************************************************
 * \fn 			
 * \brief
 *
 *************************************************************************************************/
void Mandatory_Wait( int seconds )
{
	sleep( seconds );
}

/* eof */
