eSpark-Backup/oliver-arc/Documents/Client-Shared/ARC103C_CURRENT VERSION/Software/src/utils.h

/**************************************************************************************************
 * \file			utils.h
 * \description		
 *
 * \date			
 * \version			1.0.1
 * \brief           
 *
 *************************************************************************************************/

#ifndef UTILS_H_
#define UTILS_H_

void sleep( int tm );
void sleepms( int ms );
void Mandatory_Wait( int seconds );
#endif /* UTILS_H_ */
