eSpark-Backup/oliver-arc/(commit log)

2022-06-09 MCU, Wireless RX & Buzzer circuitry added. driver section in progress.
2022-06-28 Schematic updated #5
