eSpark-Backup/oliver-arc/Documents/Client-Shared/ARC103C_LCD/Schematics/ARC103C_LCD_LAYOUT.jpg

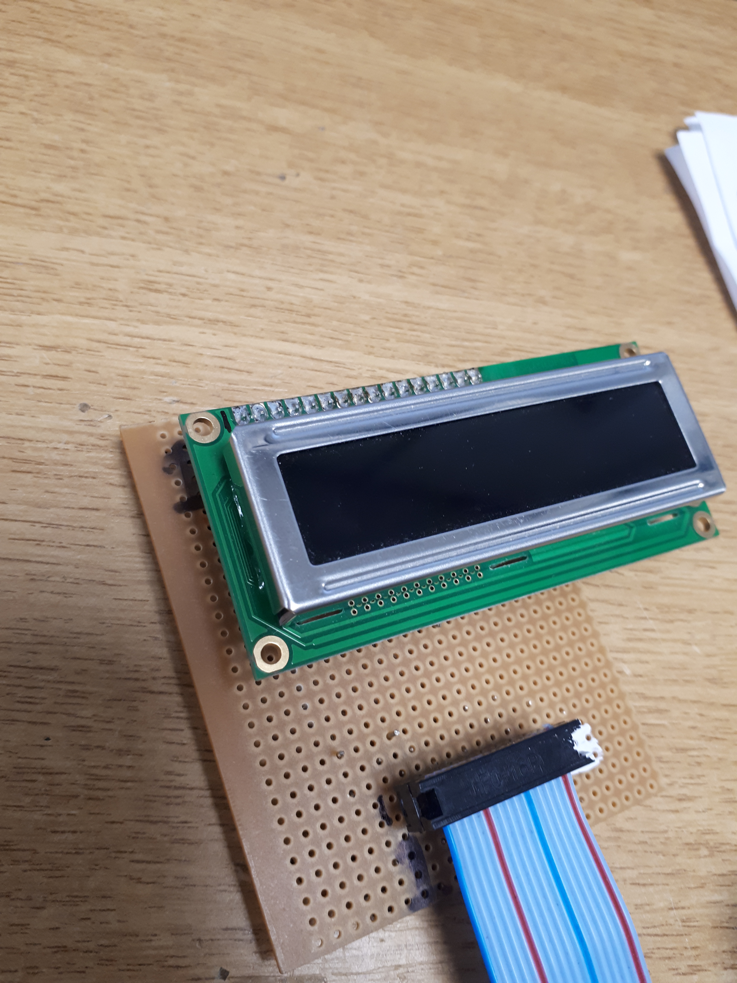
Documents/Client-Shared/ARC103C_LCD/Schematics/ARC103C_LCD_LAYOUT.jpg
